LeftShiftPlus/GiantLEDDisplayV1/README.md

# GiantLEDDisplayV1
Project details and documents related to the first Giant LED Display UMAD put together.
