LeftShiftPlus/GiantLEDDisplayV1/HardwareSourcing/Prototype for LED mount.xlsx

Item | Price each | Quantity | Total | Description | Website | Vendor
1" square aluminum tubing | 44.19 | 1 | 44.19 | 1"x1"x1/8" aluminum tubing, SELECT THE CUT IN HALF OPTION so we get 2 12ft pieces | http://www.discountsteel.com/items/6063_Aluminum_Square_Tube.cfm?item_id=148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 | Discount Steel
1/8" Aluminum sheet | 21.32 | 1 | 21.32 | 0.125 Aluminum sheet, 1'0" x 1'8" or in other words 12"x20", Shear cut -0" +1/4" is fine | http://www.discountsteel.com/items/6061_Aluminum_Sheet.cfm?item_id=140&size_no=7 | Discount Steel
1/4" welded wire mesh | 15.99 | 1 | 15.99 | 36"x10' mesh | http://www.walmart.com/ip/Gilbert-and-Bennet-308237B-Mat-36-in-x-10-1-4-in-Mesh-Hardware-Cloth/21284645 | Walmart
1/4"-20 1.75" Steel bolts | 10.62 | 1 | 10.62 | 1 pack of 50, fully threaded | http://www.mcmaster.com/#92865a548/=owbner | McMaster
1/4"-20 Nylon lock nut | 3.54 | 2 | 7.08 | 2 packs of 25 locknuts | http://www.mcmaster.com/#97135a210/=owbodu | McMaster
3/4" OD, 1/4" screw steel washers | 5.88 | 1 | 5.88 | 1 pack of 50 | http://www.mcmaster.com/#93852a102/=owbogw | McMaster
3" adjustable length clevis pin, 1/4" dia | 5.14 | 1 | 5.14 | 1 pack of 10 | http://www.mcmaster.com/#98330a155/=owbprs | McMaster
1-1/4" reusable airpin cotter pin | 6.87 | 1 | 6.87 | 1 pack 25 | http://www.mcmaster.com/#92375a100/=owbps5 | McMaster
1/4"-20 hex nut | 3.31 | 1 | 3.31 | 1 pack 100 | http://www.mcmaster.com/#94895a029/=owbr5b | McMaster
1/4"-20 3" bolt | 5.84 | 1 | 5.84 | 1 pack of 10 | http://www.mcmaster.com/#92865a554/=owbr5x | McMaster
3/4" unthreaded spacer | 1.71 | 4 | 6.84 | I dont think it matters, but select the 1/4" screw size | http://www.mcmaster.com/#92510a344/=owbsrs | McMaster
 |  | Subtotal | 133.08
 |  |  |  |  | Shipping instructions | Location for pickup
 |  | shipping | 0 | discount steel | USE IN STORE PICKUP | Minneapolis
 |  |  | 0 | walmart | USE IN STORE PICKUP | 1450 University Ave W Saint Paul, MN 55104
 |  |  | ? | McMaster | I didn't want to register to see how much shipping was... | You can just go with whatever it comes out to be
 |  | Total | 133.08 +McMaster shipping
