LeftShiftPlus/GiantLEDDisplayV1/HardwareSourcing/Full build spend.xlsx

Transaction | Number of units | Cost per unit | Total cost | Recipient | Remaining Budget | Comments
Orginal Grant amount |  |  | 0 |  | 3350 | $2900+$450 (additional) = $3350
LEDs (4meters/lot) | 34 lots | 43.00/lot | 1582.49 | aliexpress | 1767.51 | used this seller before, quality and quick
Power Supplies (300 W) | 8 | 38.49 | 307.92 | aliexpress | 1459.59
1" square aluminum tubing | 2 | 44.19 | 88.38 | Discount Steel | 1371.21 | 1"x1"x1/8" aluminum tubing, SELECT THE CUT IN HALF OPTION so we get 2 12ft pieces
1/8" Aluminum sheet | 1 | 21.32 | 21.32 | Discount Steel | 1349.89 | 0.125 Aluminum sheet, 1'0" x 1'8" or in other words 12"x20", Shear cut -0" +1/4" is fine
1/8" Aluminum sheet | 1 | 55.84 | 55.84 | Discount steel | 1294.05 | 0.125 Aluminum 18" x 54", or if you prefer 1'6"x4.6" with a shear cut +1/4"
1/4"-20 1.75" Steel bolts | 2 | 10.62 | 21.24 | McMaster | 1272.81 | 2 packs of 50, fully threaded
1/4"-20 Nylon lock nut | 4 | 3.54 | 14.16 | McMaster | 1258.65 | 4 packs of 25 locknuts
3/4" OD, 1/4" screw steel washers | 2 | 5.88 | 11.76 | McMaster | 1246.89 | 2 pack of 50
3" adjustable length clevis pin, 1/4" dia | 1 | 5.14 | 5.14 | McMaster | 1241.75 | 1 pack of 10
1-1/4" reusable airpin cotter pin | 1 | 6.87 | 6.87 | McMaster | 1234.88 | 1 pack 25
1/4"-20 hex nut | 1 | 3.31 | 3.31 | McMaster | 1231.57 | 1 pack 100
1/4"-20 3" bolt | 1 | 5.84 | 5.84 | McMaster | 1225.73 | 1 pack of 10
3/4" unthreaded spacer | 4 | 1.71 | 6.84 | McMaster | 1218.89 | I dont think it matters, but select the 1/4" screw size
1-1/4"x1-1/4" slotted angle iron | 4 | 8.87 | 35.48 | Menards | 1183.41
1/4" welded wire mesh | 2 | 19.99 | 39.98 | Walmart | 1143.43 | 36"x10' mesh
ac input cords | 2 | 4.99 | 9.98 | amazon | 1133.45 | to connect the led power supplies together, and to the input from the wall
10 port usb hub | 1 | 21.35 | 21.35 | amazon | 1112.1 | since we will have 8 teensys, we need a way to connect all of those ports to a computer, i.e. a hub
silicone rubber sealant (3oz) | 1 | 4.81 | 4.81 | amazon | 1107.29 | to waterproof the silicone end caps after the strips are cut
Micro hdmi to hdmi cable | 1 | 6.99 | 6.99 | Amazon | 1100.3 | Micro hdmi is one of the only connectors I don't have
Beaglebone Black | 1 | 54.95 | 54.95 | Amazon | 1045.35 | We don't want it, but I am amused by the option for a 2 year warranty for this little guy.
Easycap video capture device | 1 | 8.58 | 8.58 | Amazon | 1036.77 | Yeah, I know all of these are knockoffs, but should work with linux. Ive looked into it.
teensy 3.0 | 8 | 19 | 152 | pjrc | 884.77 | a teensy will drive 8 lines, 64 lines / 8 = 8 teensys
micro usb cables | 8 | 4 | 32 | pjrc | 852.77 | usb cables to drive the teensys
14mm silicone end caps | 20 | 1.5 | 36.52 | ebay | 816.25 | watch the shipping if it isnt under $10 dont buy it, oddly enough this is cheaper than china
protoboard | 1 | 18 | 18 | ebay | 798.25 | should be able to fit three driving circuits on here, and one on a perfboard I already own
Buffer chip for 3.3-5V logic (74HCT245) | 10 | 0.528 | 5.28 | Digikey | 792.97 | 296-1612-5-ND
220 resistor array (4116R-1-221LF-ND) | 10 | 0.6 | 6 | Digikey | 786.97 | 4116R-1-221LF-ND
12 screw terminal block | 4 | 1.7 | 6.8 | Digikey | 780.17 | ED2617-ND
8 screw terminal block | 4 | 1.22 | 4.88 | Digikey | 775.29 | ED2615-ND
40 pin 0.1" pin headers | 8 | 0.58 | 4.64 | Digikey | 770.65 | S1212EC-40-ND
30 pin 0.1" header sockets | 8 | 2.03 | 16.24 | Digikey | 754.41 | S7028-ND
20A 120V illuminated switches | 4 | 2.53 | 10.12 | Digikey | 744.29 | EG1534-ND
Solder | 2 | 28.71 | 57.42 | Digikey | 686.87 | Ran out of solder...
Female header pins | 1 | 1.73 | 1.73 | Digikey | 685.14 | broke one
#56 drill bit | 2 | 1.63 | 3.26 | Menards | 681.88
#54 drill bit | 1 | 1.63 | 1.63 | Menards | 680.25
1/4"x1/2" stove bolt | 1 | 0.62 | 0.62 | Menards | 679.63 | connectors for cushion clamps
3/8"x1/2" cushion clamp | 4 | 0.69 | 2.76 | Menards | 676.87 | Holds for the plug in wires
slotted angle iron 1'-1/4" 6' | 4 | 9.97 | 39.88 | Menards | 636.99 | First attempt for a stand
500' red 12awg wire | 1 | 60 | 60 | Menards | 576.99 | $30 for 50ft but need about 120ft, more cost effective to buy 500ft
500' white 12awg wire | 1 | 60 | 60 | Menards | 516.99 | $30 for 50ft but need about 120ft, more cost effective to buy 500ft
100' 16 awg speaker wire | 2 | 17.97 | 35.94 | The Home Depot | 481.05 | need very flexable wire as stiff wire is causing some LEDs to fail as their pads get ripped off
Cable tie assortment | 2 | 7.97 | 15.94 | The Home Depot | 465.11 | cable management
4" black cable tie 40cnt | 1 | 2.14 | 2.14 | The Home Depot | 462.97 | cable management
4" clear cable tie 40cnt | 1 | 2.14 | 2.14 | The Home Depot | 460.83 | cable management
48"x1"x1/16" square aluminum | 2 | 19.54 | 39.08 | The Home Depot | 421.75 | building a tabletop (half display) stand
16awg steel sheet metal 6"x18" | 1 | 6.97 | 6.97 | The Home Depot | 414.78 | tabletop stand
48"x1.5"x1/4" steel bar stock | 2 | 11.63 | 23.26 | The Home Depot | 391.52 | for ends of display to protect wiring
Heat shrink tubing | 6 | 2.5 | 15 | Axman | 376.52 | cable management
Stand off bolts | 20 | 0.2 | 4 | Axman | 372.52 | board standoffs
stand off nuts | 40 | 0.1 | 4 | Axman | 368.52 | board standoffs
1"x1"x1/8"x253" Aluminum square tubing | 1 | 33.14 | 33.14 | Discount steel | 335.38 | The angle iron we tried isnt sturdy enough to hold the display
web cam | 1 | 29.99 | 29.99 | Amazon | 305.39 | Use webcam to live stream video to the display
Wing nuts 1/4"-20 | 1 | 7.88 | 7.88 | McMasterCarr | 297.51 | pack of 25
1/4"-20 3" bolt | 2 | 5.84 | 11.68 | McMasterCarr | 285.83 | pack of 10
1/4"-20 1.75" bolt | 1 | 10.62 | 10.62 | McMasterCarr | 275.21 | pack of 50
3 outlet adapter | 2 | 5.97 | 11.94 | Amazon.com | 263.27
6ft 14/3 extension cord | 2 | 8.43 | 16.86 | Amazon.com | 246.41
12mm silicone end caps (4 pack) | 16 | 1.50 | 29.84 | Ebay | 216.57 | End caps to seal off LED strips
30 pin 0.1" header socket | 1 | 2.03 | 2.03 | Digikey | 214.54 | S7028-ND I changed the amount that I needed of the wrong part. so I am short 1.
Teensy 3 | 2 | 19 | 38 | PJRC | 176.54 | The shipping for these two is combined as they are from the same store
Mini b usb cables | 2 | 4 | 17.29 | PJRC | 159.25 | The shipping for these two is combined as they are from the same store
4 meter long LED strips | 4 | 45 | 206.36 | aliexpress | -47.11 | Needed extras to fix busted strips
200W 5V power supplies | 3 | 12.1 | 64.66 | aliexpress | -111.77
 |  |  |  | Total: | -111.77 | We ended up paying a bit out of pocket, but to be fair, we built some cool shit just about for free
