LeftShiftPlus/GiantLEDDisplayV1/HardwareSourcing/Giant LED test run budget.xlsx

Item | Quantity | Price per item | Shipping | Total | Website | Notes
Teensy 3 | 2 | 19 | 0 | 38 | http://www.pjrc.com/store/teensy3.html | The shipping for these two is combined as they are from the same store
Mini b usb cables | 2 | 4 | 9.29 | 17.29 | http://www.pjrc.com/store/cable_usb_mini_b.html | The shipping for these two is combined as they are from the same store
4 meter long LED strips | 4 | 45 | 26.36 | 206.36 | http://www.aliexpress.com/item/BLACK-PCB-4m-WS2811-LED-digital-strip-60leds-m-with-60pcs-WS2811-built-in-the-5050/700420631.html
200W 5V power supplies | 3 | 12.1 | 28.36 | 64.66 | http://www.aliexpress.com/item/200W-40A-Switching-Power-Supply-For-LED-Strip-light-200V-240V-100V-120V-AC-input-5V/500135277.html
 |  |  | Total Total | 326.31
