LeftShiftPlus/GiantLEDDisplayV1/(list of files, cad)

Other CAD files:
HardwareLayout/LED panel design.dwg
