LeftShiftPlus/GiantLEDDisplayV1/HardwareLayout/Giant LED display Prototype Schematic.PDF

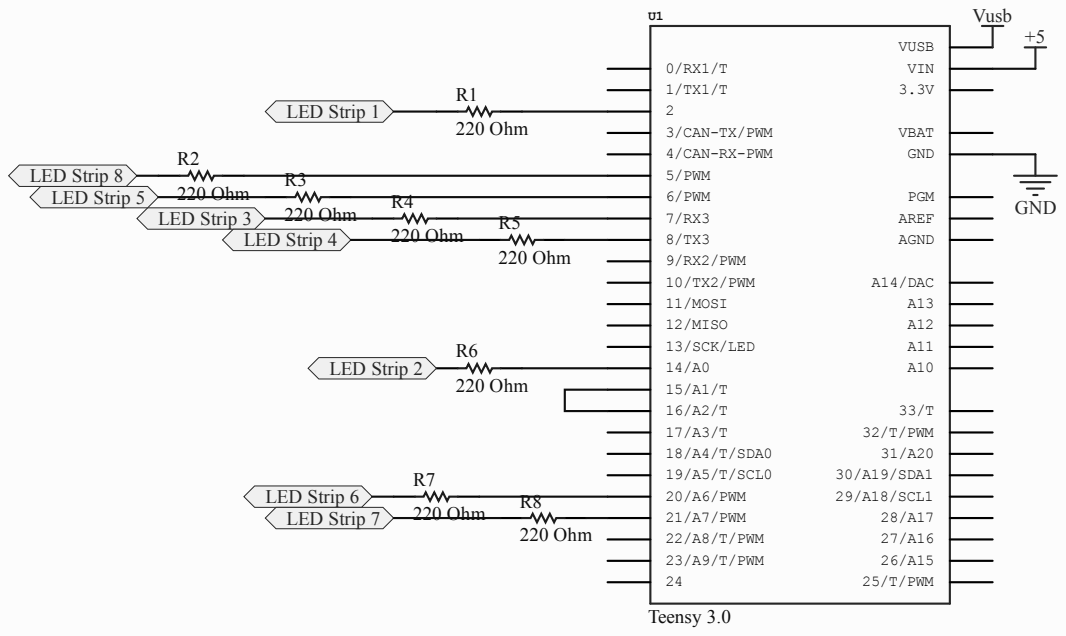
[picture p1: page 1]

Title
Prototype LED Strip Wiring
