LeftShiftPlus/GiantLEDDisplayV1/HardwareLayout/LED panel design-Model.pdf

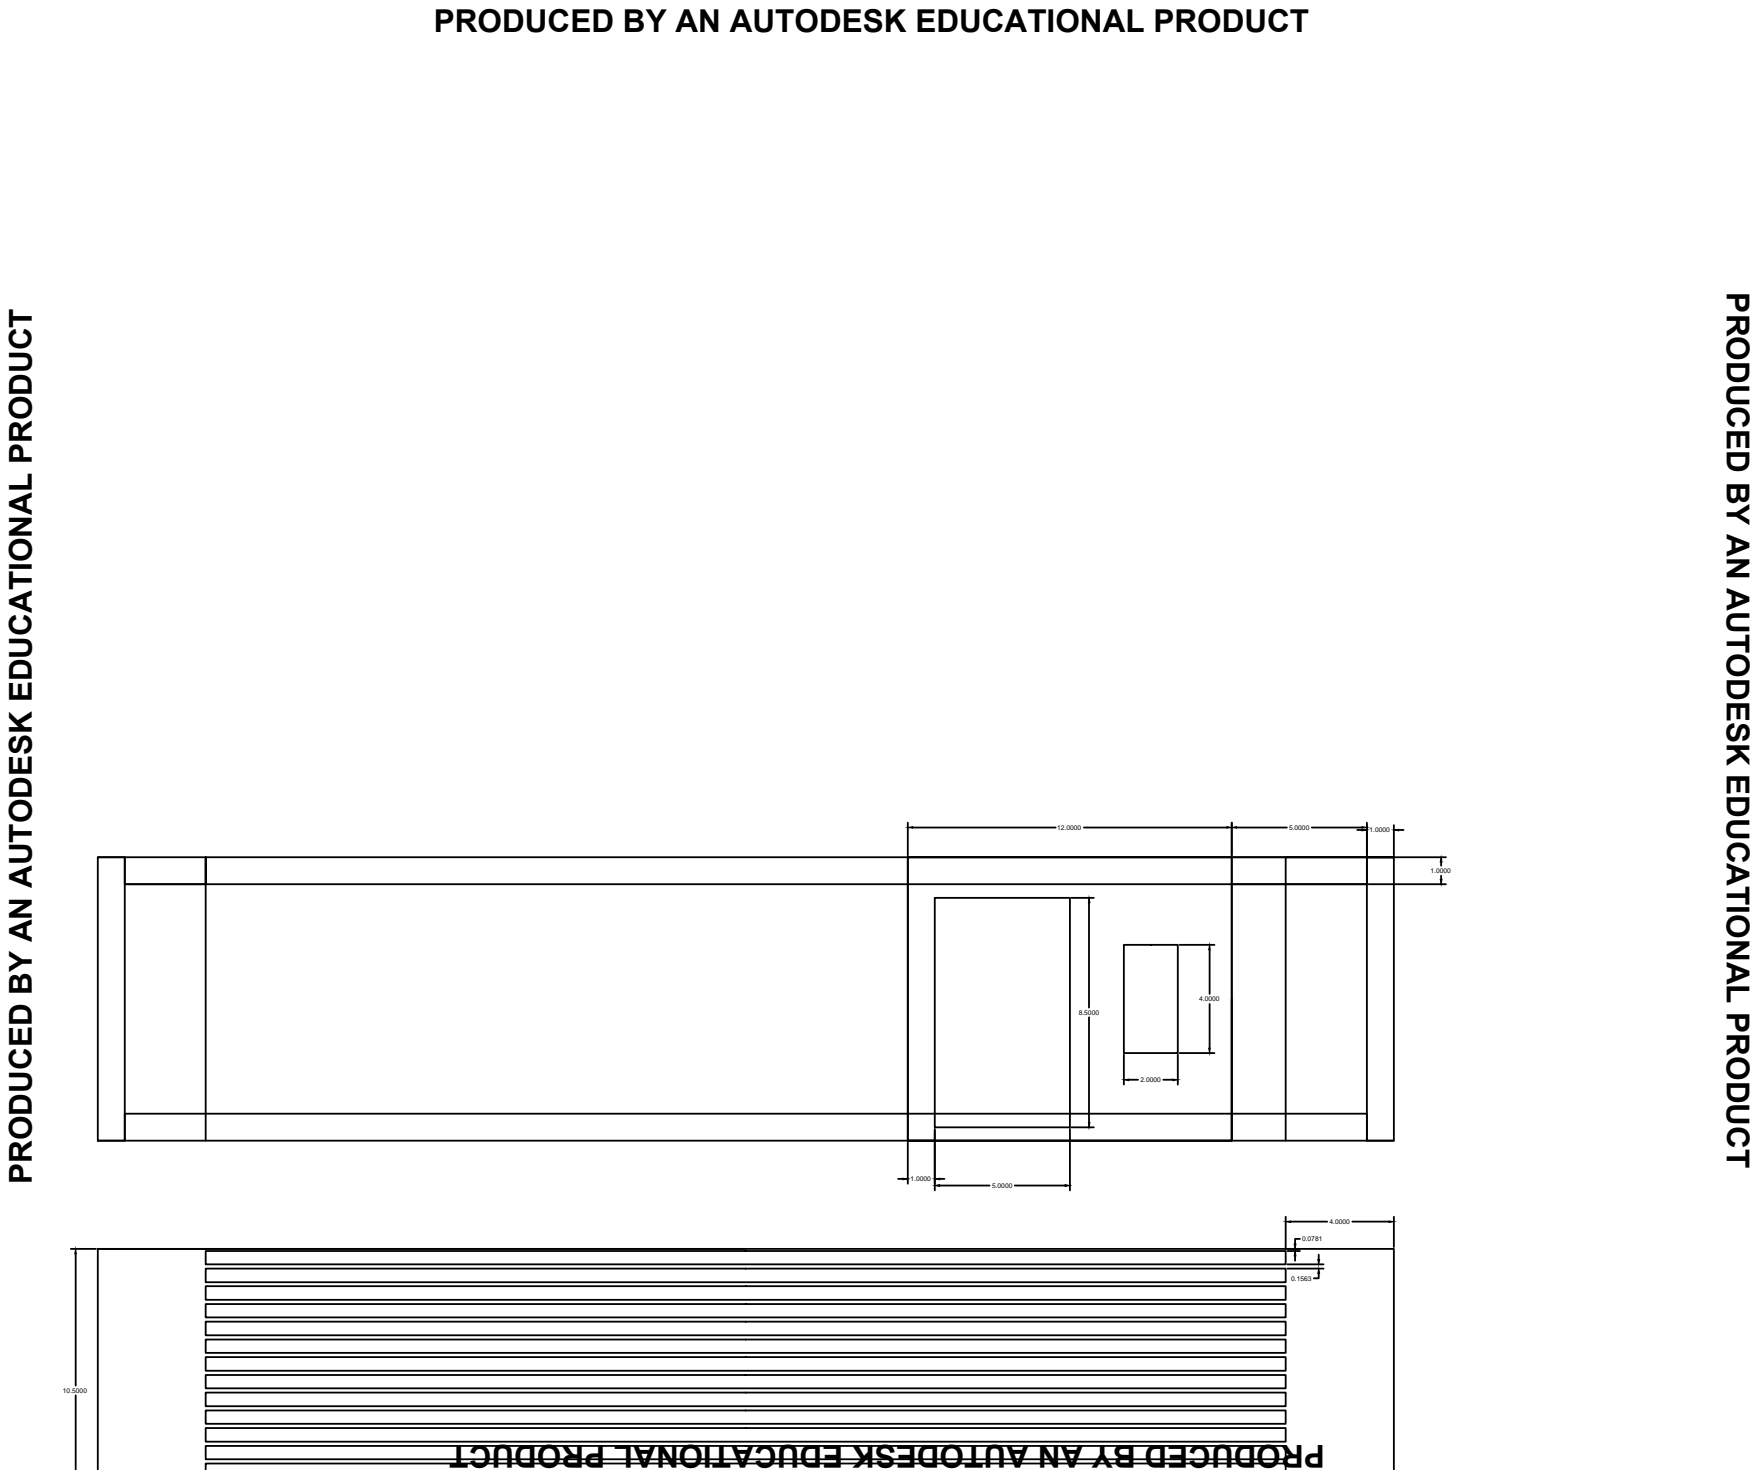
[picture p2: page 1]

PRODUCED BY AN AUTODESK EDUCATIONAL PRODUCT
