LeftShiftPlus/GiantLEDDisplayV1/(commit log)

2018-03-20 Add files via upload
    Test run budget covers the original planned build for prove out. Prototype mount covers the initial idea for a frame and mount for the full display. Finally, the full build spend covers the entirety of the full build. Pulling in some of the previous BOMs and creating a complete list.
    [Full build spend.xlsx, Giant LED test run budget.xlsx, Prototype for LED mount.xlsx]
2018-03-20 Add files via upload
    Basic layout of the two part frame, along with LED spacing and sizing.
    [LED panel design.dwg]
